jl13-ahma/wyatt/hardware/r4/BUY-NOW-China.html

28 OCTOBER 2026 · PRINT PROTOTYPE R4

# One body. Screen between speakers.

One horizontal leather-wrapped body: left speaker, central display, right speaker, with room sensing inside the left wing.

Printer assembly instructions · Print STL files · Editable STEP/STP files

Sensor + wiring, delivered allowance≈¥104¥49 sensor + ¥35 wiring allowance + ¥20 delivery

Complete case, sensor and finish≈¥349–519Reuse suitable power; printing and labour require a quotation.

## Prototype procurement reference

This dated estimate was prepared for a bench build whose owner already had the Korvo board, LCD, microphones, amplifiers, two speakers and data cable. Public builders must source those separately. These allowances are not a complete Wyatt build cost or retail price. No firmware is included in this CAD-only release.

Part / buying link | Quantity | Budget | Price basis
DFRobot SHT40 temperature + humidity breakout, SEN0428 (https://www.dfrobot.com.cn/goods-3365.html)Buy this exact 14 × 17 mm breakout, AD1B / I²C address 0x44 for the planned prototype configuration, not a bare SHT40 chip or a different-size board. The integrated R4 sensor carrier uses a low-profile soldered pigtail; a tall header/plug must pass the supplied clearance test before use. | 1 | ¥49 | Manufacturer China page listed ¥49 on 28 October 2026; stock and delivered price need checkout confirmation.
Four-wire sensor harness + soldering / safe board interposer (https://s.taobao.com/search)Short flexible four-conductor lead, about 30 cm for the initial fit/test lead, then cut to the verified internal route, with strain relief. 3.3 V, GND, SDA, SCL. Have the technician verify the occupied shared bus and connector orientation on this exact S31 board. | 1 set | ¥35 | ¥35 planning allowance; search link, not a verified ready-to-plug Korvo accessory. Technician must quote.
Case/sensor fasteners, small ties and insulating shims (https://s.taobao.com/search)12 × M2.5x10 pan-head self-tapping screws; 2 × M2.5x10 countersunk self-tapping screws; 2 × M2x8 countersunk self-tapping screws; 2 × M2x4 pan-head self-tapping screws; 2 × 2.5mm cable ties. Check actual hardware against the supplied pilot and head-clearance limits. | 18 screws + 2 small ties | ¥15 | ¥15 allowance; exact count/length/head must follow the supplied CAD assembly list and pilot coupon.
Speaker rim pads, sensor-cap silicone foam gasket and non-slip feet (https://s.taobao.com/search)Sensor cap: soft, cured closed-cell silicone foam sheet 0.5 mm thick, with a 0.3 mm design gap. Fit the coupon before final cutting. A separate split foam block seals the wire channel; use the R4 cut-stock dimensions and the left-grille divider strip. All vent and driver air paths must remain as designed. Speaker pads support only the stationary frame; keep every air opening clear. | Small offcuts/set; follow R4 seal and grille-divider thickness | ¥10 | ¥10 small-offcut allowance; search lead, not a verified in-stock sheet. Ask the assembly/print shop to quote the specified soft foam, speaker pads and feet.
R4 one-block horizontal enclosure, flush side grilles, hidden rear support and sensor fit coupons (https://www.jlc-3dp.cn/)Ask a local shop for charcoal PETG if available. JLC currently lists black ABS/ASA rather than PETG: request an explicit material quote and print coupons in that same process before the case. Units mm, scale 100%; print individual STL parts, not the assembly STEP. | Per print list; two speaker grilles | ¥180–350 | ¥180–350 planning allowance retained pending a fresh R4 quote. Includes small sensor parts and one fit-coupon round; reprints/finishing may cost extra.
Smooth cognac-brown leather (https://s.taobao.com/search)0.6–0.8 mm measured thickness; cut to the finished print. Charcoal front, sensor air slots and all acoustic/connector openings remain uncovered. | Small offcut; buy after coupon fit | ¥30 | ¥30 allowance; search link.
Leather adhesive compatible with selected print material (https://s.taobao.com/search)Test on scrap first; finish and fully cure the empty shell away from the temperature/humidity sensor before fitting electronics. | Small tube | ¥10 | ¥10 allowance; search link.

Delivery allowance: ¥20 total, not a guarantee for multiple sellers. Full estimate with a new ¥40 supply: ¥389–559. No order has been placed.

## Only if needed, or later

- Suitable 5 V / 3 A USB-C power supply, e.g. DFRobot FIT0640 (https://www.dfrobot.com.cn/goods-2085.html) — ¥40. Manufacturer China listed ¥40 on 28 October 2026; US-plug variant, confirm outlet fit. Skip if you already own suitable power. Dry-fit the actual plug and lead in the R4 port-access trial before the full print.
- SD3031 RTC DFR0998 + CR1220 coin cell (https://www.dfrobot.com.cn/goods-3657.html) — ¥45. Later upgrade only. Earlier ¥40 module + ¥5 cell allowance; today’s module price not reverified. No fitted mount or driver in this R4 release. Do not add it to this print order. Cell retains time only and cannot power an alarm.

## How the design fits your parts

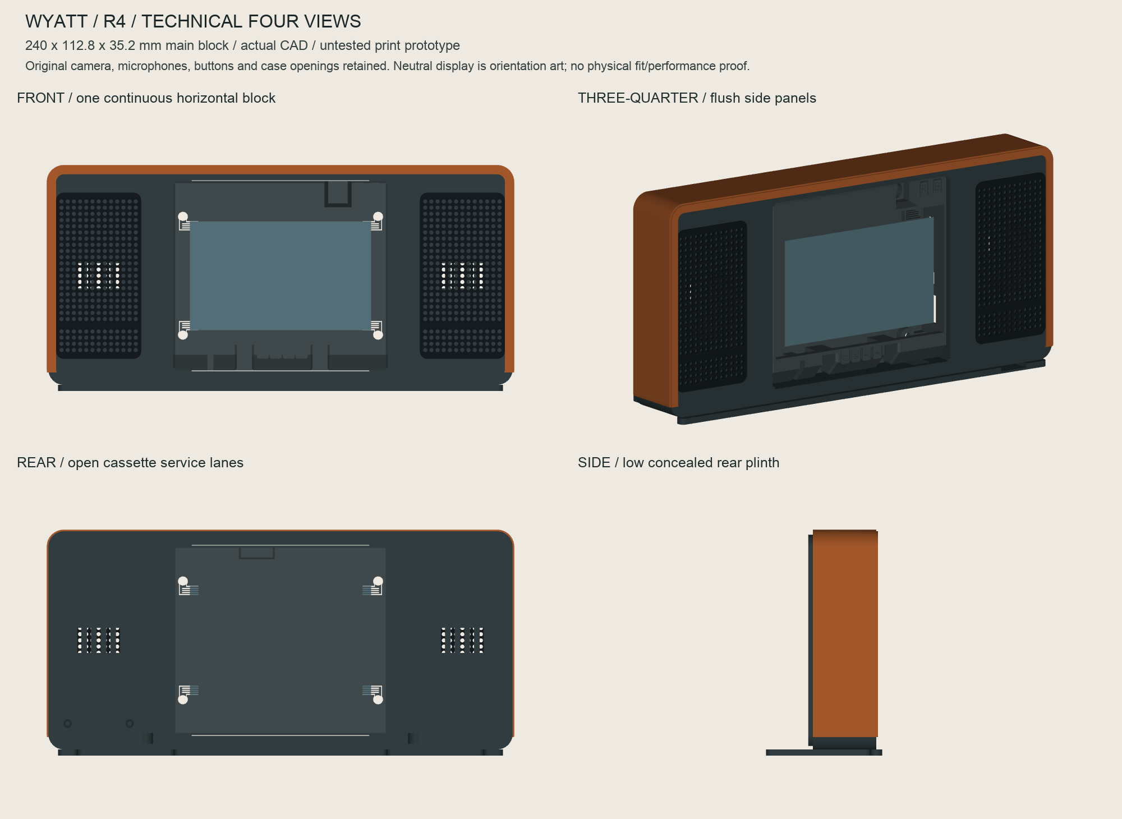
[picture p2: hardware/r4/Preview/Shannon-technical-four-views.png]
Actual R4 CAD technical views including sensor housing
 Technical view of the exported CAD, not a photograph or a completed physical fit test.

The main housing keeps the official Korvo inner case and its control/connector openings. The printed R4 main block is 240 × 112.8 × 35.2 mm, with speakers flanking the central Korvo. The low concealed rear support gives a 240 × 116 × 60 mm printed assembly. The provisional leather reference adds up to 241.7 × 116.85 × 60 mm; confirm the real leather stack after printing. The temperature/humidity sensor is in a separate ambient pocket below the left speaker, inside the same body. Two side speaker bays allow a 42 mm outer rim, a maximum 20 mm listed driver depth, and wiring clearance: each bay has a 43 mm nominal bore; its seat is 5 mm behind the front plane, with rear wiring clearance shown in the CAD. The 36 mm front aperture must be checked against the actual stationary rim using the included coupon; it must never press the moving surround.

The SHT40 sits in a ventilated internal pocket below the left speaker, separated from that chamber and the electronics space. Its air path and carrier are intended to limit heat transfer; a physical thermal comparison is still required before trusting the installed reading. Keep leather, adhesive, foam and coating away from the sensing inlet and air openings.

The files are ready for a physical fit prototype. The case has not been printed or fitted yet. Start with the supplied coupons, then the official inner-case fit, then the full set. Geometry validation does not establish temperature accuracy, acoustic quality or final production fit.

## Wiring handoff / 接线说明

Ask an electronics technician to use the existing shared S31 I²C bus: GPIO0 = SDA, GPIO1 = SCL, 3.3 V and GND. There is no verified free plug-and-play four-pin sensor socket. Verify the board revision, safe interposer, pin order, pull-ups and cable strain relief before power is applied. Do not move an occupied LCD connector or connect sensor wires to speaker outputs.

请购买指定的 SEN0428 成品模块，不要买裸芯片或其他尺寸的转接板。请电子师傅先核对原理图和这块板的版本，再制作约30厘米用于初次试装的4芯软线，最终长度按实物内部走线确认与安全转接。传感器窗口、通风槽不可涂胶、贴皮或压泡棉。外壳粘胶必须充分固化后再装传感器。本公开CAD版不含固件；后续需使用经验证的兼容固件核对实测温湿度，目前原型没有已安装的室温探头。

## P1S and front camera

R4 is the selected design. The P1S can fit the main shell at 100% scale with the specified centred brim, subject to the complete Studio slice check. Preserve the original camera opening and check the live-preview corners after fitting.

P1S setup notes · Camera/selfie fit check · Measured front keepout diagram

## Take this to the printer

Send the complete R4 ZIP and bring the actual Korvo, both speakers, SEN0428 and Power/UART cables for fit checks. Trial the roof/side port access with the actual plugs before printing the full cabinet. Ask for millimetres, 100% scale and quantities in the print list. Do not print the combined assembly or leather/sensor reference solids. The removable rear support, two flush side grilles and internal sensor carrier are separate print parts within one horizontal silhouette. The 240 mm main shell needs a suitable large printer; a 256 mm bed class or larger is practical with the specified brim. Check the usable bed allowance in PRINT-MANIFEST.json. Keep the case at its designed scale.

把完整 R4 压缩包给店家，并带实物主板、两只喇叭及传感器。先打印小样，按说明逐项试装。STL 直接用于切片；STEP/STP 用于检查或修改。不要将装配参考模型整体打印，也不要把配合问题用整件缩放解决。

R4 supersedes the earlier enclosure for this sensor-equipped build. China shopping searches are sourcing leads, not verified compatible items. Machine-readable BOM · Manufacturer specifications and source notes · Installed sensor test plan.
