jl13-ahma/wyatt/hardware/r4/Preview/Horizon-UI-illustrative.png

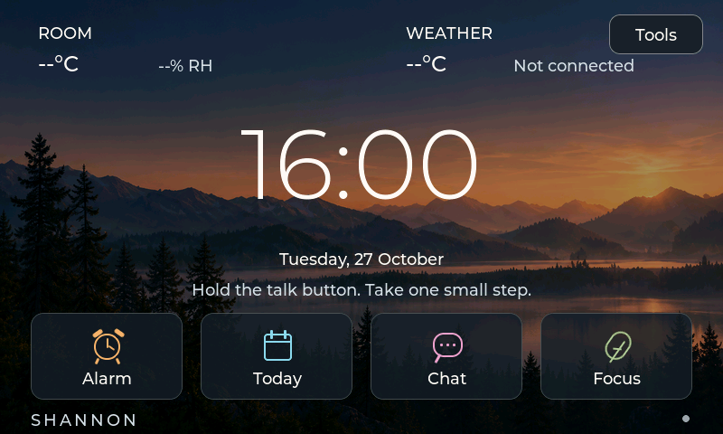
hardware/r4/Preview/Horizon-UI-illustrative.png
