jl13-ahma/wyatt/hardware/r4/Preview/Shannon-integrated-sensor-open.png

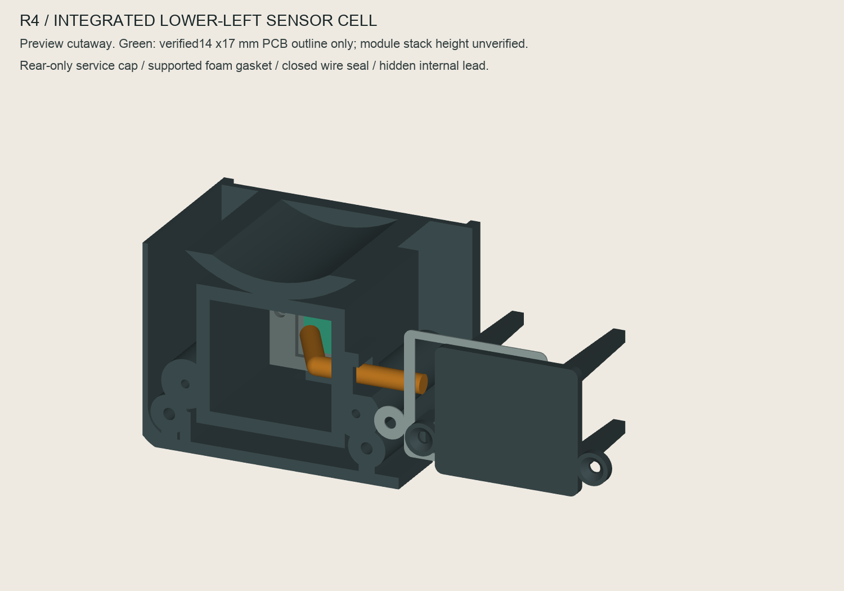
hardware/r4/Preview/Shannon-integrated-sensor-open.png
