jl13-ahma/wyatt/hardware/r4/STP/00_Horizontal_Assembly_REFERENCE.stp

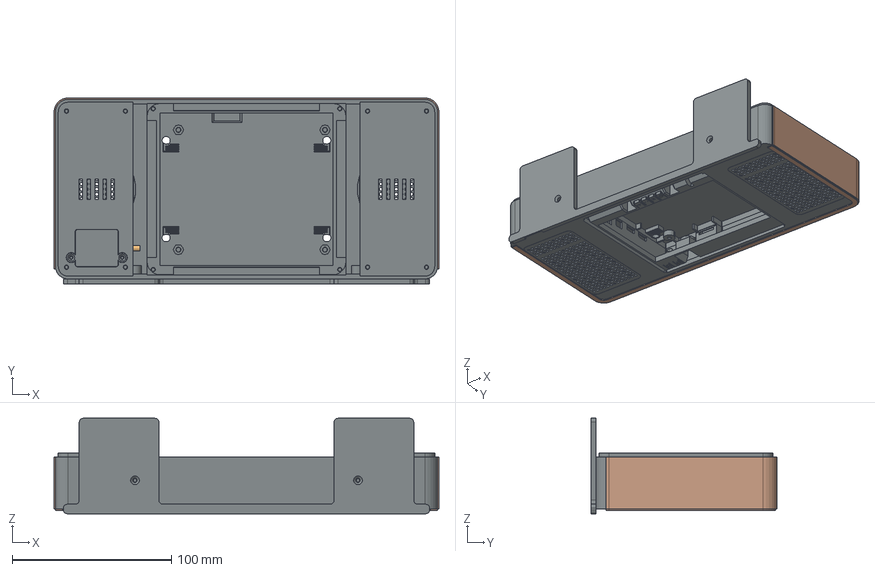
[picture p5: CAD file, 2026-10-28]
hardware/r4/STP/00_Horizontal_Assembly_REFERENCE.stp
241.7 x 116.8 x 60.0 mm
cabinet
left_rear
right_rear
cassette_retainer
plinth
official_top
official_bottom
grille_L
grille_R
sensor_cap
sensor_carrier
sensor_retention
leather_REFERENCE
sensor_PLANFORM_ONLY
sensor_harness_REFERENCE
soft_gasket_REFERENCE
