jl13-ahma/wyatt/hardware/r4/Official-originals/ESP32-S31-Korvo-1_Case_top_20260603.STEP

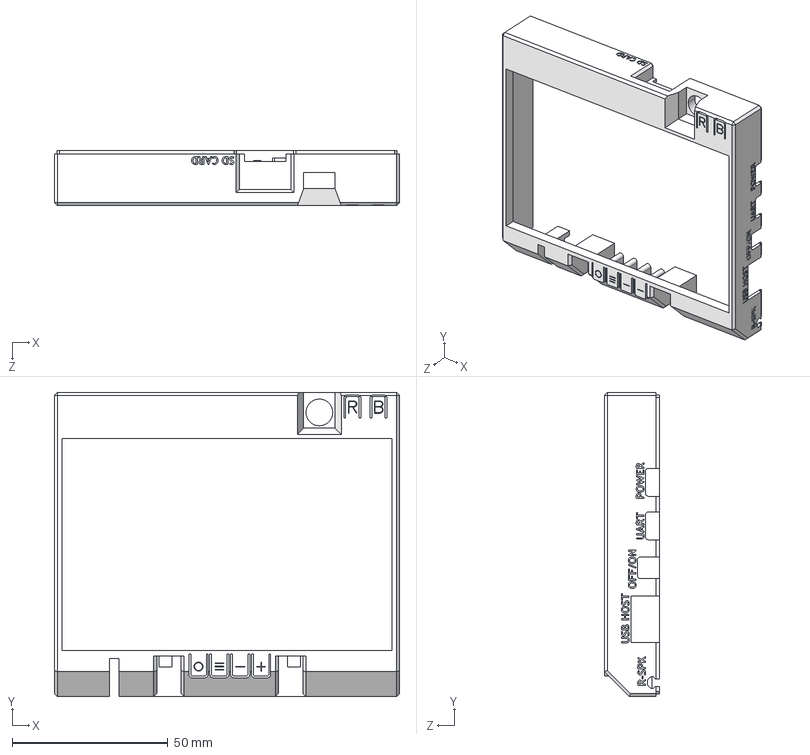
[picture p6: CAD file, 2026-10-28]
hardware/r4/Official-originals/ESP32-S31-Korvo-1_Case_top_20260603.STEP
110.9 x 97.8 x 17.8 mm
