jl13-ahma/wyatt/hardware/r4/STP/REFERENCE_SEN0428_PLANFORM_ONLY.stp

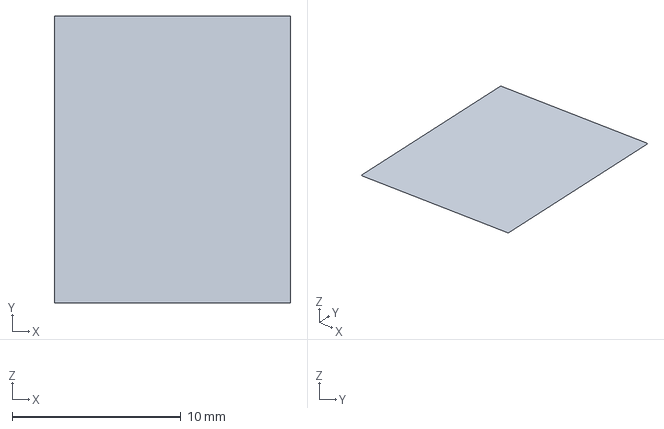
[picture p7: CAD file, 2026-10-28]
hardware/r4/STP/REFERENCE_SEN0428_PLANFORM_ONLY.stp
14.0 x 17.0 x 0 mm
