jl13-ahma/wyatt/hardware/r4/STP/TEST_06_Cassette_Port_Lane_Coupon.stp

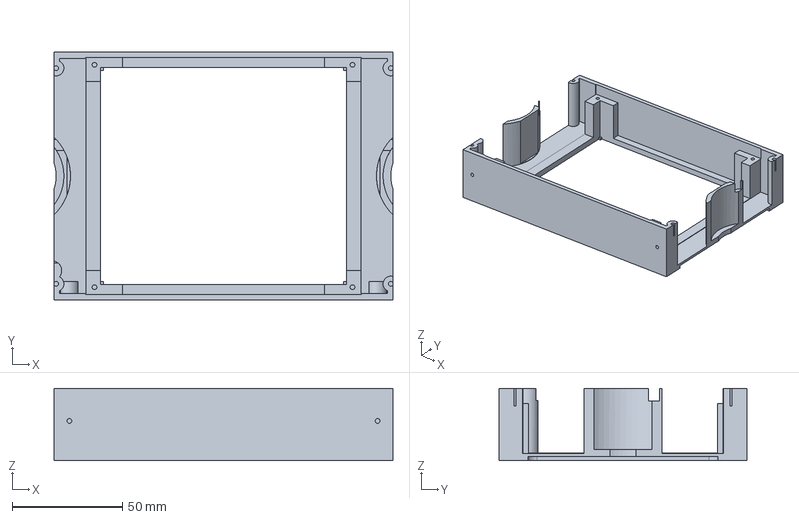
[picture p8: CAD file, 2026-10-28]
hardware/r4/STP/TEST_06_Cassette_Port_Lane_Coupon.stp
154.0 x 112.8 x 32.8 mm
