jl13-ahma/wyatt/hardware/r4/STP/REFERENCE_Internal_Sensor_Harness_NOT_FOR_PRINT.stp

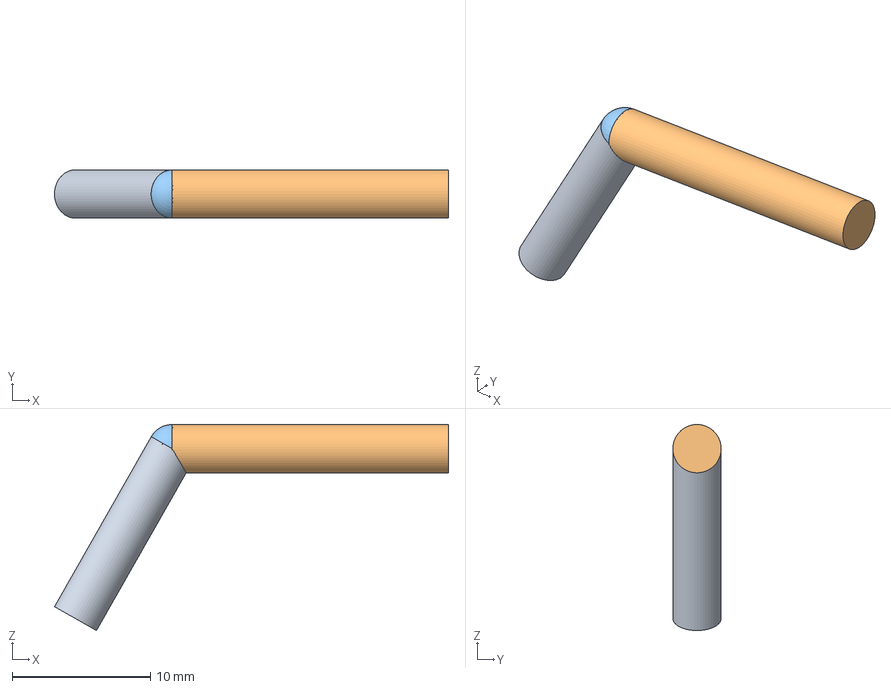
[picture p9: CAD file, 2026-10-28]
hardware/r4/STP/REFERENCE_Internal_Sensor_Harness_NOT_FOR_PRINT.stp
28.5 x 3.50 x 14.9 mm
