jl13-ahma/wyatt/hardware/r4/STP/05_Flush_Speaker_Grille_PRINT_TWO.stp

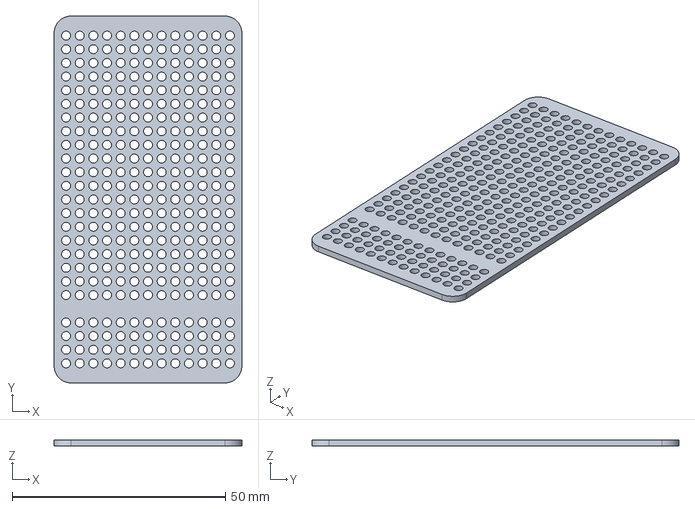
[picture p10: CAD file, 2026-10-28]
hardware/r4/STP/05_Flush_Speaker_Grille_PRINT_TWO.stp
44.0 x 86.0 x 1.50 mm
