jl13-ahma/wyatt/hardware/r4/STP/REFERENCE_Grille_Foam_Frame_And_Divider_NOT_FOR_PRINT.stp

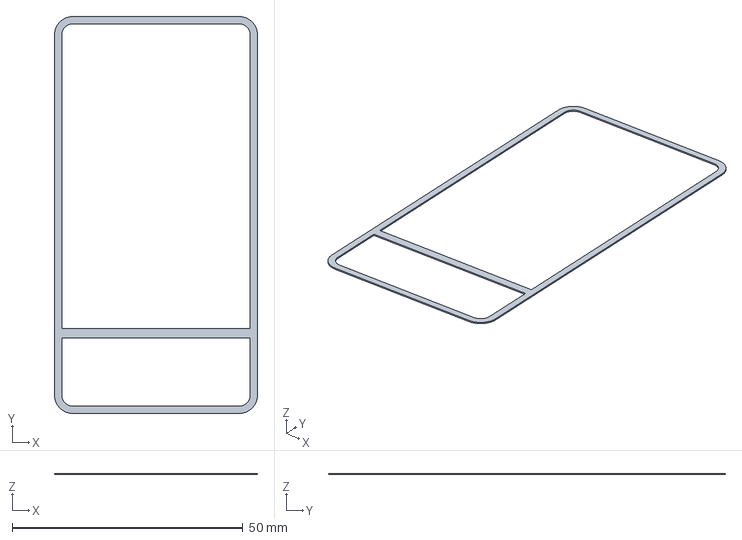
[picture p11: CAD file, 2026-10-28]
hardware/r4/STP/REFERENCE_Grille_Foam_Frame_And_Divider_NOT_FOR_PRINT.stp
44.0 x 86.0 x 0.3 mm
