jl13-ahma/wyatt/hardware/r4/STP/REFERENCE_Split_Wire_Seal_NOT_FOR_PRINT.stp

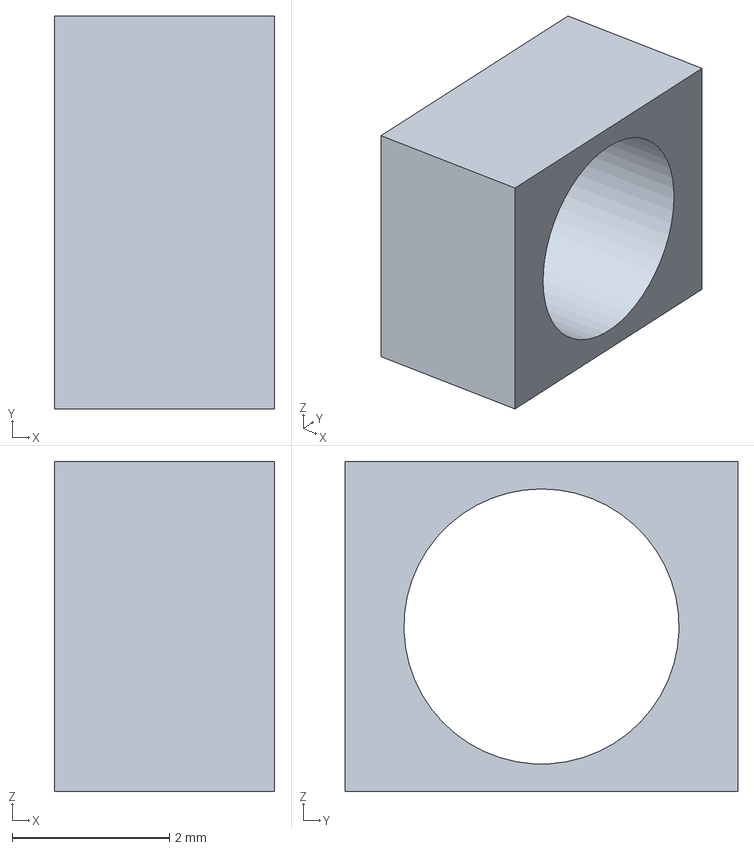
[picture p12: CAD file, 2026-10-28]
hardware/r4/STP/REFERENCE_Split_Wire_Seal_NOT_FOR_PRINT.stp
2.80 x 5.00 x 4.20 mm
