jl13-ahma/wyatt/hardware/r4/STP/01_Horizontal_Cabinet.stp

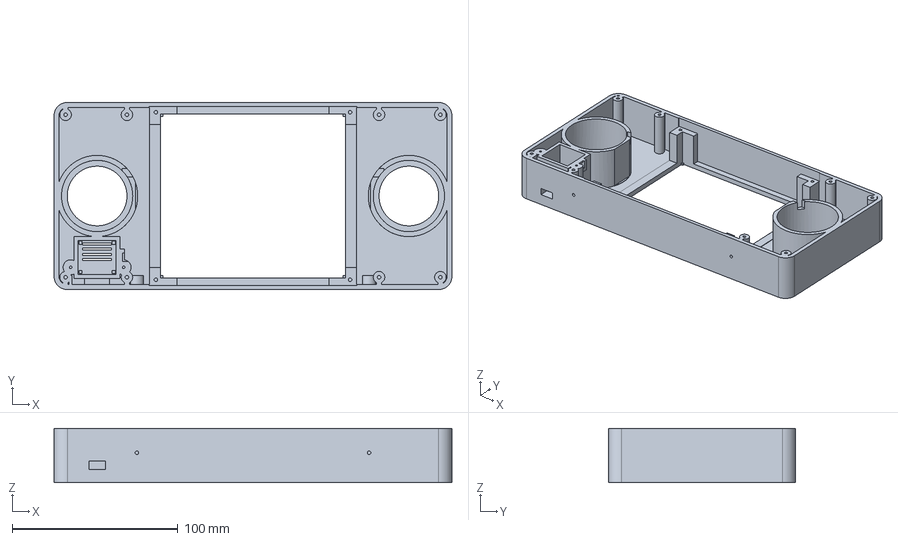
[picture p13: CAD file, 2026-10-28]
hardware/r4/STP/01_Horizontal_Cabinet.stp
240.0 x 112.8 x 32.8 mm
