jl13-ahma/wyatt/hardware/r4/STP/TEST_05_Integrated_Sensor_Cell.stp

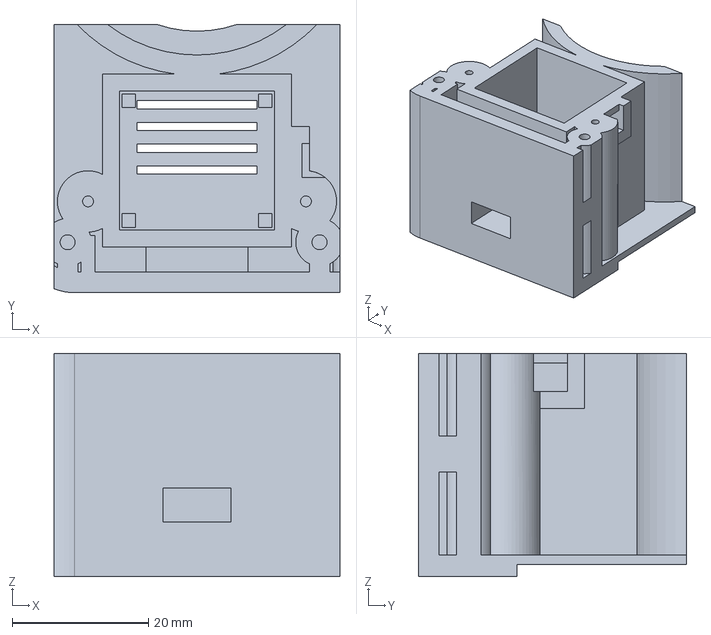
[picture p14: CAD file, 2026-10-28]
hardware/r4/STP/TEST_05_Integrated_Sensor_Cell.stp
42.0 x 39.4 x 32.8 mm
