jl13-ahma/wyatt/hardware/r4/STP/06_Low_Concealed_Desk_Plinth.stp

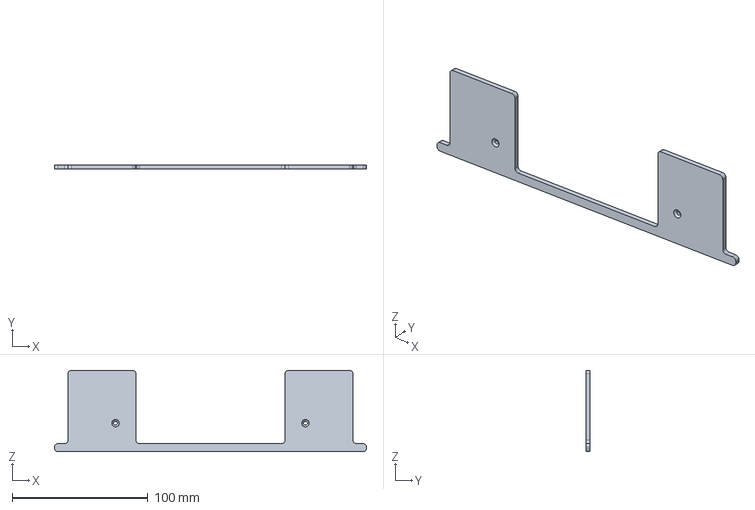
[picture p15: CAD file, 2026-10-28]
hardware/r4/STP/06_Low_Concealed_Desk_Plinth.stp
230.0 x 3.20 x 60.0 mm
