jl13-ahma/wyatt/hardware/r4/STP/REFERENCE_Silicone_Gasket_NOT_FOR_PRINT.stp

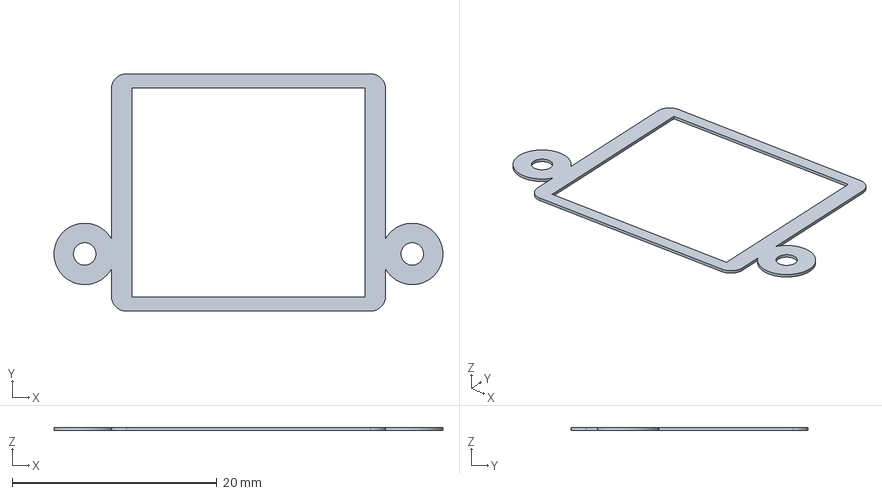
[picture p17: CAD file, 2026-10-28]
hardware/r4/STP/REFERENCE_Silicone_Gasket_NOT_FOR_PRINT.stp
38.0 x 23.2 x 0.3 mm
