jl13-ahma/wyatt/hardware/r4/STP/TEST_01_Official_Case_Clearance_Frame.stp

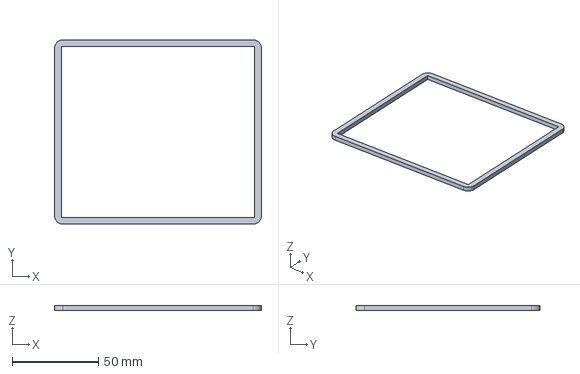
[picture p18: CAD file, 2026-10-28]
hardware/r4/STP/TEST_01_Official_Case_Clearance_Frame.stp
119.8 x 106.7 x 3.00 mm
