jl13-ahma/wyatt/hardware/r4/STP/08_SEN0428_Internal_Edge_Carrier.stp

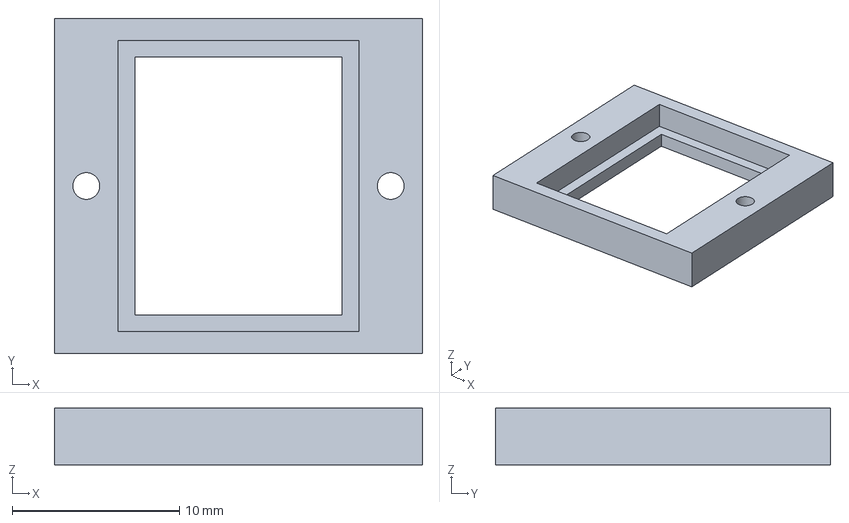
[picture p19: CAD file, 2026-10-28]
hardware/r4/STP/08_SEN0428_Internal_Edge_Carrier.stp
22.0 x 20.0 x 3.40 mm
