jl13-ahma/wyatt/hardware/r4/STP/09_SEN0428_Rear_Retention_Frame.stp

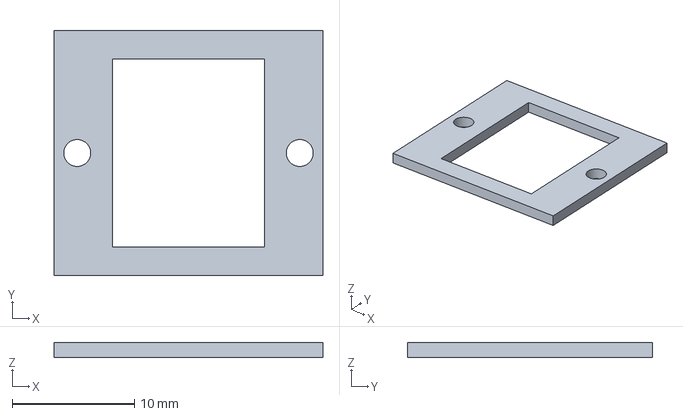
[picture p20: CAD file, 2026-10-28]
hardware/r4/STP/09_SEN0428_Rear_Retention_Frame.stp
22.0 x 20.0 x 1.20 mm
