jl13-ahma/wyatt/hardware/r4/STP/TEST_02_Speaker_Diameter_Rings_1_2_3.stp

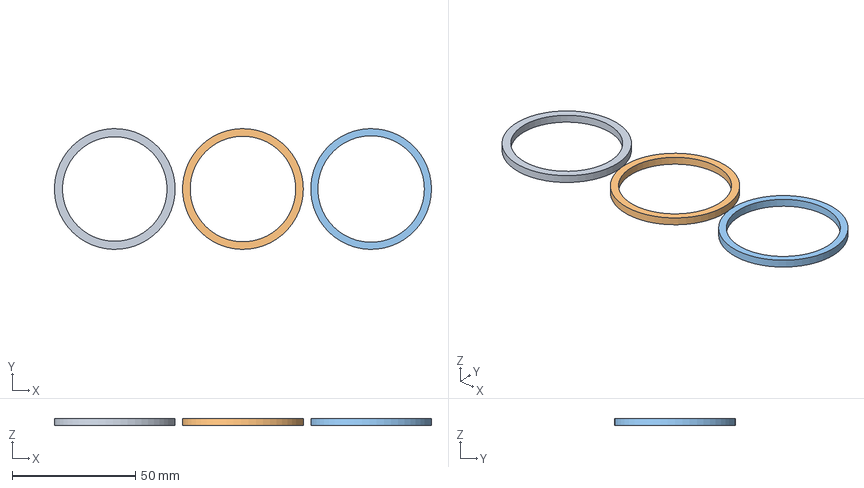
[picture p21: CAD file, 2026-10-28]
hardware/r4/STP/TEST_02_Speaker_Diameter_Rings_1_2_3.stp
153.0 x 49.0 x 3.00 mm
