jl13-ahma/wyatt/hardware/r4/STP/07_Internal_Sensor_Service_Cap.stp

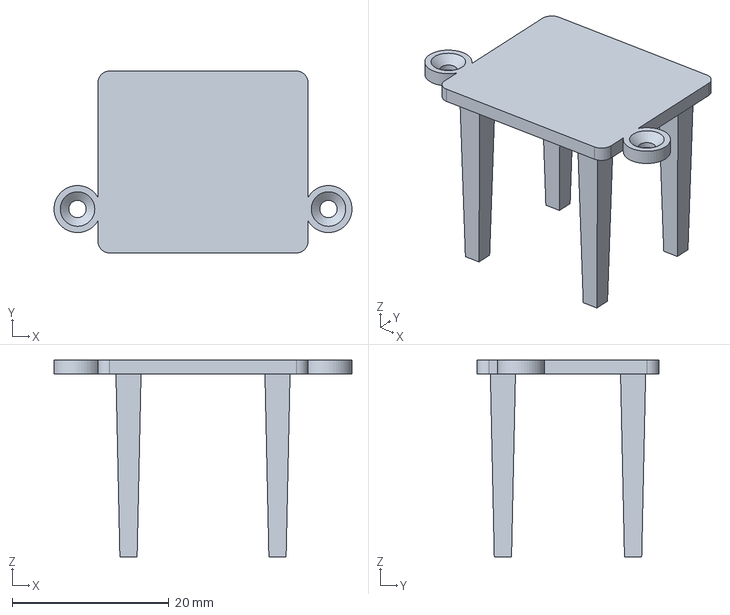
[picture p22: CAD file, 2026-10-28]
hardware/r4/STP/07_Internal_Sensor_Service_Cap.stp
38.0 x 23.2 x 25.1 mm
