jl13-ahma/wyatt/hardware/r4/STP/TEST_03_Flush_Grille_And_Speaker_Seat.stp

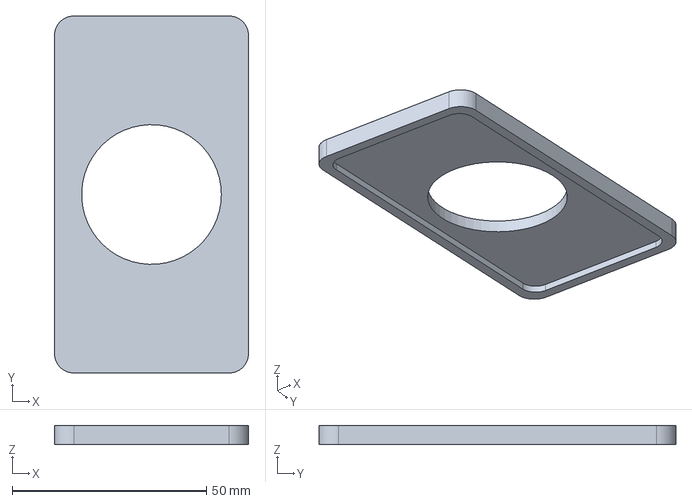
[picture p23: CAD file, 2026-10-28]
hardware/r4/STP/TEST_03_Flush_Grille_And_Speaker_Seat.stp
50.0 x 92.0 x 5.00 mm
