jl13-ahma/wyatt/hardware/r4/STP/REFERENCE_Cognac_TOP_SIDE_Wrap_NOT_FOR_PRINT.stp

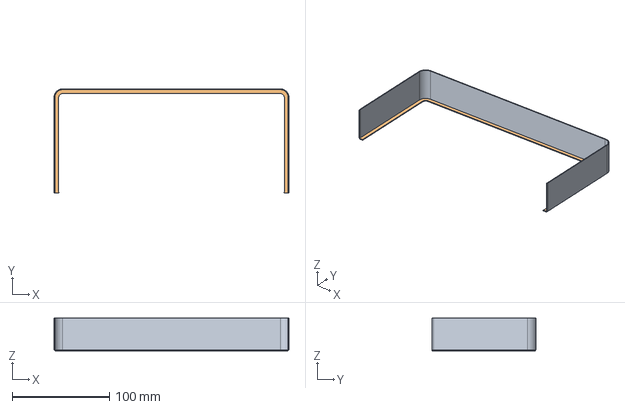
[picture p24: CAD file, 2026-10-28]
hardware/r4/STP/REFERENCE_Cognac_TOP_SIDE_Wrap_NOT_FOR_PRINT.stp
241.7 x 107.2 x 33.6 mm
