jl13-ahma/wyatt/hardware/r4/STP/04_Official_Cassette_Retainer.stp

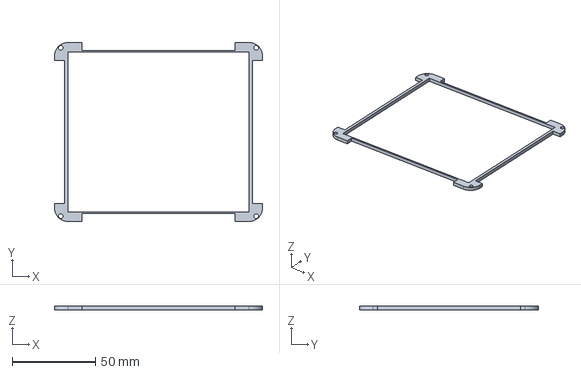
[picture p25: CAD file, 2026-10-28]
hardware/r4/STP/04_Official_Cassette_Retainer.stp
124.8 x 107.4 x 2.40 mm
