jl13-ahma/wyatt/hardware/r4/STP/03_Right_Wing_Rear_Cover.stp

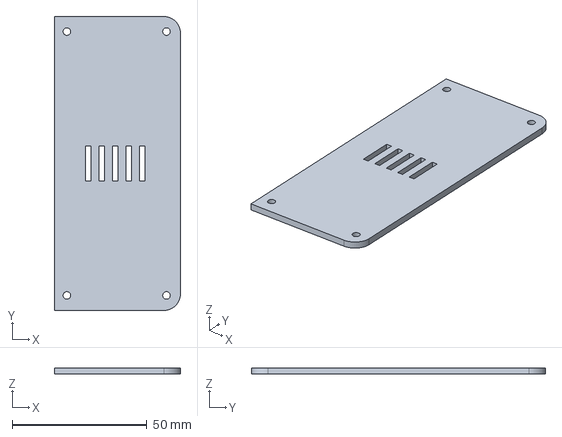
[picture p26: CAD file, 2026-10-28]
hardware/r4/STP/03_Right_Wing_Rear_Cover.stp
46.8 x 109.2 x 2.40 mm
