jl13-ahma/wyatt/(list of files, cad)

Other CAD files:
hardware/r4/Official-originals/ESP32-S31-Korvo-1_Case_top_20260603.STL
hardware/r4/STL/01_Horizontal_Cabinet.stl
hardware/r4/STL/02_Left_Wing_Rear_Cover.stl
hardware/r4/STL/03_Right_Wing_Rear_Cover.stl
hardware/r4/STL/04_Official_Cassette_Retainer.stl
hardware/r4/STL/05_Flush_Speaker_Grille_PRINT_TWO.stl
hardware/r4/STL/06_Low_Concealed_Desk_Plinth.stl
hardware/r4/STL/07_Internal_Sensor_Service_Cap.stl
hardware/r4/STL/08_SEN0428_Internal_Edge_Carrier.stl
hardware/r4/STL/09_SEN0428_Rear_Retention_Frame.stl
hardware/r4/STL/TEST_01_Official_Case_Clearance_Frame.stl
hardware/r4/STL/TEST_02_Speaker_Diameter_Rings_1_2_3.stl
hardware/r4/STL/TEST_03_Flush_Grille_And_Speaker_Seat.stl
hardware/r4/STL/TEST_04_Leather_And_Screw_Pilots.stl
hardware/r4/STL/TEST_05_Integrated_Sensor_Cell.stl
hardware/r4/STL/TEST_06_Cassette_Port_Lane_Coupon.stl
hardware/r4/STP/TEST_04_Leather_And_Screw_Pilots.stp
