jl13-ahma/wyatt/hardware/r4/README-PRINT-FIRST.txt

WYATT R4 / HORIZONTAL CABINET / PRINT-PROTOTYPE HANDOFF
28 October 2026 · all CAD dimensions mm · geometry/source CC BY-SA4.0

FORM AND FILES
One continuous rounded block surrounds the central official cassette and two
front-facing speakers. Two flush44×86mm perforated panels conceal the round
speaker apertures. A single cognac material reference wraps the top and sides;
there are no stacked speaker/display boxes. The room sensor is internal.

Nominal main printed block240W×112.8H×35.2D. The low plinth is3.2mm tall, with
concealed rear pads and a narrow connecting bar, within the main width. Printed
assembly240×116×60. With the illustrative0.85mm leather/adhesive reference,
241.7×116.85×60. Rear pan-head screws may project2.8mm locally; they remain
inside the rear-foot depth. Leather is applied after measuring the actual print,
not an invented moulded texture. It is excluded from print meshes.

Espressif's unchanged official110.9×97.8×23.6 inner-case reference is centred in
the opening. Camera, microphones, front buttons, source port openings and the
board's original shell are retained. Rendered93.6×56.16 display/UI is orientation
art only, excluded from manufacturing geometry. It is not measured LCD fit or a
working device claim. The default public preview uses a neutral display.

PRINT CAPACITY / QUANTITY / MATERIAL
The main shell is240mm wide. With5mm brim each side, it needs at least250mm
USABLE bed width; a256-class or shop-qualified large-format bed is practical.
A normal220×220 bed is insufficient. No scale-down, automatic cut or splitting.
If the shop changes orientation/material/process, repeat its own fit coupons.
Local PETG if available; ABS/ASA/nylon/resin are alternatives requiring their own
same-material coupons. Supplier PETG availability is not assumed. Discuss0.2mm
layers and4walls with the shop; these are starting settings, not slicer proof.
The wings are hollow with nominal3mm outer/chamber walls,2.5mm sensor-cell walls
and local ribs/bosses. This is a shell, not a solid plastic brick. CAD solid volume
is not filament use or weighed mass; use an actual slicer quote.

PRINT-MANIFEST.json is the quantity/orientation authority. Installed custom set:
01 cabinet×1;02 left rear cover×1;03 right rear cover×1;04 retainer×1;
05 grille×2;06 low plinth×1;07 sensor cap×1;08 carrier×1;09 rear frame×1.
Official top/bottom each1 only if not already available. Original stand is unused.
05 has an intentionally solid horizontal bearing band atY−25.6: do not add holes.
06STL is already oriented with its broad foot faces on the bed.07STL is rearface
on bed, tapered posts upward. Other flats may retain assembly coordinates: drop
to bed, preserve scale.04 is one connected frame with1.15mm top/bottom crossrails;
handle gently and test it before assembling the actual cassette.

COUPONS BEFORE THE FULL SHELL
TEST01 checks the official case outline only, not plugs.
TEST02 contains three diameter rings42.4/42.8/43.2; print all three.
TEST03 is the actual flush-grille/5mm speaker-seat stack: print with05×1 and use
EACH actual17/20mm driver. Check stationary rim contact, dust-cap/cone protrusion
AND powered excursion at the intended prototype volume before full printing.
TEST04 checks actual leather/adhesive and screw pilots.
TEST05 is the actual lower-left cell including its bottom duct. Print together
with07×1,08×1,09×1; trial the real SEN0428, pigtail, foam seals and screws.
TEST06 is a154mm-wide FULL-DEPTH crop of the actual cassette surround, roof,
side lanes and limiting inner wing walls. Install the owned official cassette,
04 retainer and ACTUAL occupied USB/Power/UART cables, SD card and tools. Verify
insertion, removal, bends and Boot/Reset/function access before the240mm print.
Good04/05/07/08/09 trial parts can be reused; these are not extra installed sets.

PORTS AND INTERNAL WIRING — ACTUAL CABLE GATE
Rear-open side service lanes lie atabsX55.2..71,Y±43,Z3.5..35.2. The unchanged
source side wall is atabsX55.45, giving15.55mm to the inner wing wall. This is
space, not a promise that any straight USB plug or cable bend fits it. Top/bottom
ports have a rear-open pocket betweenY49.35 and53.9 (and its negative twin),
with a continuous2.5mm roof/floor supporting the leather. About5mm clearance
above the actual case edge is primarily SD/low-profile/tool access, not a claimed
finger space. Verify all actual cables and controls on TEST06. Do not infer a
free path beside an occupied USB connector from an empty case model.

Both speaker leads exit behind the deeper20mm driver into the service lanes.
The sensor's reference3.5mm bundle ends atX−67/Y−37/Z29.3 in the open rear lane,
BEFORE the official shell. Actual sensor entry/board connector is a physical
routing gate. Open the actual inner case and identify a usable existing port and
removable connector. Do not drill the source case or PCB from this reference.
No exposed dangling sensor lead is intended; no connector-free entry is claimed.
Thread bare/free pigtail ends through the sensor's closed channel before fitting
a larger connector. Leave service slack and independent strain relief after the
actual port trial; the two small cable ties are routing/spare consumables, not a
claim of a measured fixed connector path. Do not pull sensor pads/header.
A roughly30cm initial pigtail is an allowance; trim only after the real route and
detached thermal-test slack are established. Confirm electrical pinout against the exact board revision and official
manufacturer documentation. This CAD-only release supplies no firmware or
wiring harness; it is not an electrical validation.

SPEAKERS AND FLUSH PANELS
43mm bores centred atX±94/Y0 start atZ5 and end32.8. The user's42mm rim and
listing20/17mm depths are the source basis; magnets, stationary frame, cone and
excursion are unmeasured. The deeper20mm driver ends nominally atZ25, leaving
rear wiring space.36mm front acoustic apertures have a5mm seat plane. The flush
panel isZ0..1.5: nominal seat-to-grille distance3.5mm, still a physical trial.
Different drivers need individual removable rear stops/pads against stationary
frame only; never press the moving cone or assume one spacer fits both depths.
There is no invented mounting-hole pattern or universal speaker clamp promise.

Panels are44×86, recesses44.4×86.4×1.8. Use a fitted thin removable contact/
adhesive frame around the perimeter and the2mm divider atY−25.6. Its soft CAD
reference is0.3mm thick, designed from0.5mm cured closed-cell foam; the ACTUAL
adhesive/foam stack must fit that gap and make contact without bowing the panel.
The solid panel band supports that divider. It separates the shallow under-panel
speaker-front gap from lower sensor vent rows, rather than allowing one internal
front plenum. Ambient air outside remains shared. Cure all adhesive before sensor
installation. No vent, perforation or sensing inlet may be blocked.

SENSOR / SEALS / SERVICE
Only the SEN0428 PCB14×17mm and nominalM2 hole pitch10mm are verified. Hole
edge offsets are not used. Board thickness, component/inlet location, blank edge
lands and assembled header/cable height remain unverified. The green surface is
a planform, not an assembled module model. Do not use the inconsistent linked
manufacturer schematic as mechanical component-position authority.
Sources: https://www.dfrobot.com.cn/goods-3365.html
https://wiki.dfrobot.com/sen0428/

The isolated cell is centredX−94/Y−37,22.8×20.4, with its rear seal planeZ32.8.
Its top is5.3mm below the round speaker bore; separate walls enclose the cell and
bottom ambient duct. These distances are not a thermal-accuracy guarantee.
Carrier22×20 has nominal0.4mm side/0.2mm end clearance. Its14.4×17.4×2.2 edge
pocket is a design allowance, not a board measurement. Positive end/side fences
prevent sliding out; front/rear frames contact nominal0.8mm PCB edges only.
Inspect actual blank edges first. If a pad/component/inlet falls under a contact,
STOP and revise that frame. A removable thin inert PET edge shim may remove rattle
only on verified blank lands. Do not glue the chip or use cable tension as retention.
Prefer a low-profile soldered pigtail. Tall header/female stacks are not guaranteed.

Remove left rear cover02, then the two rear countersunk07 screws for sensor access.
Cap outerfaceZ34.9 is0.3mm below the wing rearplane35.2. Four tapered posts capture
the carrier with0.2mm nominal axial play, never chip pressure. Trial these posts
and actual module stack on TEST05; do not force a cap against a tall connector.
The fully supported primary gasket land uses cured SOFT CLOSED-CELL SILICONE FOAM
0.5mm free thickness compressed to0.3.40%compression is provisional: coupon-test
force, full contact, cap flatness and thread strength. Solid rubber is not assumed
equivalent. It is not an air-tightness claim based on printed joints.

A separate closed5Y×4.2Z wire feedthrough runs alongX−82.6..−78.4. Its rear roof
is1.4mm solid (Z31.4..32.8), independent of the primary gasket. A snug split foam
block approximately2.8X×5.2Y×4.5Z free is hand-fitted into2.8×5×4.2. Cut a snug
slit/individual wire holes; inspect all contact faces. The wire-seal block, not an
open warm-air chimney, separates the cell from the electronics/service lane.
Do not force a finished4pin plug through this unmeasured opening.

Ambient enters through aligned lower-left panel holes atY−38.4/−35.2/−32/−28.8,
and a separate bottom duct atX−94,Z8..13. The plinth tunnel exits FORWARD above
the desk and retains1.1mm floor, rather than terminating in a blocked desk gap.
Do not cover it with a desk mat, feet, leather turn-under or support residue.

ASSEMBLY ORDER / HARDWARE
Finish, fully cure and air printed/coated/leather-glued parts BEFORE installing
the sensor. Sensirion flags adhesive/plasticizer VOCs and cleaners as contaminants.
No glue, paint, IPA or acetone on the sensor. No fabric/foam across its inlet.
Trial the actual cassette/ports, both speakers and sensor coupons first. Install
speakers with individually fitted stationary-frame stops, route loose leads,
seat the official case, fit04retainer, then thread/fit sensor wiring and foam.
Install08/09carrier on four small seats, soft gasket and07cap. Fit rear plates,
front contact frames/panels and low plinth. Verify no wire/cone contact and no
closed ventilation path before power. Actual connector entry must already pass.

New custom hardware, official-case screws reused separately:
12×M2.5×10 pan-head self-tapping (8wing covers+4retainer),2.2mm blind pilots;
2×M2.5×10 countersunk self-tapping (plinth underside),90deg,D≤5,flush heads;
2×M2×8 countersunk self-tapping (sensor cap),90deg,D≤4,H≤1.2,1.6 pilot7.2deep;
2×M2×4 pan-head self-tapping (sensor rearframe),D≤4,H≤1.6,2.8mm engagement.
No new nuts.2small2.5mm cable ties allowance. Real screw thread/head must pass
same-material coupons. Gentle torque; never drive to a blind end or crack a post.

PHYSICAL ACCEPTANCE
Check actual cone excursion, cable strain, all port/control access and reversible
sensor service. On a flat desk trial the finished unit's normal touch force and
gentle cable tug without tipping/sliding; no tip or impact rating is claimed.
For room readings, keep heater off and record raw data: same-sensor detachedA→
installedB→detachedA, minimum30min and10min stable observations, in idle and
highbrightness/WiFi/audio/camera modes. Suggested prototype screening targets:
added bias≤0.5°C/3RHpercentagepoints, mode drift≤0.3°C. These are engineering
targets, not manufacturer/system-accuracy claims. Revise isolation/airflow before
using guessed offsets or making room-temperature claims if the target fails.

REBUILD / QA
CadQuery2.8: run build_horizontal_case.py, validate_package.py, then
render_technical_preview.py. Source literals drive the model; editing JSON alone
does not rebuild it. Official source files and licenses are unchanged.
geometry-validation.json records dimensions/transforms; package-validation.json
records actual reimported solids, closed/nondegenerate/positive meshes, collisions,
head/driver/harness/service/air gauges, gasket backing and roof support. Independent
review is supplied separately when present. These checks are not physical tests.

P1S AND SELFIE CAMERA / OWNER-SELECTED R4
R4 is the selected design. Read P1S-printing.txt for the 256 mm bed/100% scale/
centred 5 mm brim setup, and Camera-and-selfies.txt for the original camera
opening keepout and actual live-preview corner/framing trial. No printer job
or assembled-case camera test has been run.
